AhmadMahi/nexus-face/(commit log)

2026-09-24 NEXUS Face: ESP32-C3 companion with knock navigation and OTA
    Knock driven: one for next, two for the next screen, three to act, four
    for home. Eight screens covering clock, weather, messages, the animated
    face, sensors, settings and system.
    The ADXL only reports single taps, so taps are collected into a burst
    and classified afterwards, which is the only way to tell three from two.
    Weather from Open-Meteo, located by IP. The clock uses NTP, and falls
    back to the time your browser hands over when there is no route out.
    Settings are a real list you can drive by knocking: brightness, sleep
    timeout, eye style, check for update, reboot.
    Credentials are copied into flash on first boot and read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
2026-09-24 v1.2.0: work sessions, and fix the story never arriving
    The story always failed with 'bad reply'. ArduinoJson was being handed
    h.getStream() directly, which is the raw socket including the chunked
    transfer markers OpenAI replies with, so the parse could never succeed.
    It reads through getString() now, which unpicks the chunking first. The
    screen also reports the real reason instead of always blaming a missing
    key, and the key has its own endpoint so saving it no longer needs a
    reboot and takes effect immediately.
    New FOCUS screen and a plan you build on the page. Each stretch has a
    name and a length, runs in order with a countdown filling the screen
    and the name scrolling underneath, and fl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
2026-09-24 v1.4.1: say why an update will not fit
    "no room" was the whole message, which told you nothing and sent you
    looking in the wrong place. The slot an update lands in is fixed by the
    partition table, that table is written over USB, and nothing done over the
    air can change it. So the device now names the numbers: "will not fit",
    then "1352k into 1280k slot". A board with no second OTA slot at all says
    so separately.
    The page carries the same figure under System as "ota room", so the
    ceiling is visible before you walk into it.
2026-09-24 v1.4.2: eyes with pupils, and cards that wait for you
    The eyes were filled shapes, which read as blocks rather than eyes. Each
    one now carries a pupil and a glint, on every frame the face appears in:
    boot, waking, dozing off and falling.
    The card at the end of boot ran out a fixed delay, so knocking during it
    did nothing and the knock then arrived late, after the card had gone. A
    knock now ends the card within a single poll, and the rest of that burst
    is muted so it does not also step the carousel. The same applies to the
    name card and both offline cards.
    That card is also rebuilt. "READY" was in the corner of a title bar and
    the four knocks were two ragged centred lines. It now reads HOW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
2026-09-24 v1.5.0: the call to prayer, a calmer face, and a name
    Named RAFIQ, which is Arabic for companion, and what the thing actually
    is. The repo, the sketch and the release asset keep their old names so
    updates already out in the field still find them.
    The face was twitching. The library clears the panel and pushes it itself,
    so a caption added afterwards needed a second push and the panel showed
    both frames. Boot now draws its own eyes and pushes once, so it sits
    perfectly still, and the blink went from every three seconds to every
    seven or so. Each boot stage also looks like what it is doing: a sweep
    that lights each sense as it passes, waves going out for the network, and
    a face with a hand go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
2026-09-24 v1.6.0: two games, played by tilting
    GAMES sits between SHORT READS and SETTINGS. Two knocks opens it, one
    knock moves between the two icons, two knocks plays.
    Snake steers by tilt, four ways, and works up from 220ms a step to 120ms.
    That floor is deliberately slower than a keyboard snake would want, since
    tilt carries more lag than a button does.
    Brick slides its paddle by tilt, proportionally, and the paddle edges send
    the ball off at an angle so it steers as well as blocks.
    Tilt is meaningless without knowing how the thing is sitting, and this one
    could be upright or flat. Rather than guess, it asks once: hold still,
    tilt right, tilt away. That mapping is kept in flash and never asked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
2026-09-24 Add an input test build, and draw the car as a car
    The test build is a detour, not the firmware. It carries WiFi, the
    clock, the page and OTA, and nothing else, so three ways of driving the
    device can be judged against each other without anything else in the
    way: tilt, squeeze and taps.
    It always installs whatever release is current, even one numbered below
    itself. A version check would otherwise strand the device on it, and
    this is meant to be left.
    Worth saying plainly about squeeze: this board cannot feel one. There is
    no force sensor, and unlike the older ESP32 the C3 has no touch
    peripheral at all. What the detector watches for is the patch of low
    frequency wobble a hand leaves when i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
    [rafiq_test.ino]
2026-09-24 v2.0.0: lean to drive it, and an About page
    Squeeze is gone. The board cannot feel one, the detector was guessing,
    and a control you cannot rely on is worse than no control at all.
    Tilt earns its place instead, as a second way in rather than a
    replacement. Knocking keeps working exactly as it did, always, so a lean
    that is misread or a calibration that has drifted can never strand you
    on a screen with no way back.
    Lean down for the next thing, up for the one before, left to go in,
    right to come out, and hold it up for three seconds for home. Up does
    double duty, so it only counts as "the one before" once you let go:
    holding past three seconds means you wanted home, and it does not fire
    bot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
2026-09-24 v2.0.1: choose what to install, rather than just taking the newest
    Check update used to be a single button that fetched the newest release
    and wrote it, with nothing in between. It now opens two choices.
    Newest release names what it found and asks before writing anything. One
    knock moves between Yes and No, two knocks answers.
    Earlier releases lists the last eight with the running one marked, and
    asks the same question about whichever is picked. Going back to an older
    build is deliberately allowed: there should always be a way off a release
    that turned out badly, and the confirmation step is what makes that safe
    rather than reckless.
    The install path no longer compares versions at all. Th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
2026-09-24 v2.0.2: stop the fall animation firing when you lean it
    It was never going to sleep. The eyes were closing because the fall
    animation was running: it ends by flattening them to six pixels for
    forty frames, which looks exactly like eyes shut, and input() has
    already returned by then so nothing responds for about a second. Shaking
    it appeared to wake it because the animation had simply finished.
    It only showed up with leaning because leaning is the only reason to
    pick the thing up. On a desk it never unloads.
    The free fall detector was set to 438mg for 100ms, the sensitive end of
    the datasheet range and a window far shorter than any real fall: a drop
    from desk height is 250ms or more. A hand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
2026-09-24 v2.0.3: the sleep loop, which was a stuck lean all along
    The pattern of sleeping, waking on a shake and sleeping again was the
    real fault, and it was not the fall detector.
    Rest is measured while you hold the device, because the calibration asks
    you to hold it. Put it down on a desk afterwards and the resting pose no
    longer matches: every lean reads as already held over. The gesture latch
    only clears when the lean returns near zero, which now never happens, so
    no gesture fires again. Nothing then refreshes the idle timer, so it
    sleeps, wakes on a shake, and sleeps again. Exactly as described.
    Once it has sat still for five seconds, rest now settles to wherever it
    is actually sitting. Recov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
2026-09-25 v2.0.4: leaning it can finally wake it
    The sleeping was never the fall detector, and it was not the stale
    resting pose either. Both of those were real, and fixing them changed
    nothing you could see, because neither was the cause.
    Every check that woke the device or kept it awake tested the MAGNITUDE
    of the acceleration. Gravity has the same magnitude whichever way the
    thing is turned: leaning it changes the direction, not the size. A forty
    five degree lean moves the magnitude by about one hundredth, well under
    the twelve hundredths those tests wanted, so a lean was invisible to all
    of them. The gyro term was the only one that could have caught it, and
    it reads zero unless you are mid rotati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
2026-09-25 v2.0.5: a way to stop it, and something to look at
    Four goes at this and it still sleeps, so this release stops guessing.
    SETTINGS, Sleep after, now has "never" on the end of the list. That ends
    the dozing immediately whatever is causing it, and it costs nothing on a
    device that sits on a desk. Existing settings keep their meaning because
    never was appended rather than put at the front.
    The page has a "Why it sleeps" card, live: awake or asleep, how long it
    has been idle and against what limit, what woke it last, how many times
    it has slept, whether each sensor is answering, the raw gravity vector,
    and how far the lean reading has moved against the threshold it has to
    cross. Enough to see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
2026-09-25 v2.1.0: watch faces, and prayer times that stay put
    Ten faces for the clock screen, chosen in SETTINGS. Six laid out by
    hand, two that lean the way you do and right themselves a couple of
    seconds after the thing is set down, and two with something that pours.
    Whatever the water or sand covers is inverted rather than swallowed by
    it, so it stays readable as the level moves. The faces read the sensor
    themselves, so they work whether or not leaning drives the device.
    Prayer times are no longer refetched daily. They are kept in flash and
    refreshed only when asked, from SETTINGS, or once every fiftieth boot.
    They barely move week to week, and refetching meant losing them whenever
    the network hap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
2026-09-25 v2.2.0: a Mac in the loop, and a door that closes
    Rafiq on the Mac drives the robot over the same API the page uses, so
    there is one command set rather than two. Nothing here becomes a
    dependency: close the laptop and the clock, the prayer times, the reads
    and every knock carry on exactly as before.
    pairing six digits on the panel, and after that every call has to
    carry the token. This closes a door that was standing open
    since the beginning: anyone on the same network could post
    to this device. The page pairs the same way and stays the
    way back in, so a failing app can never lock you out.
    focus start it from the Mac. Th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
2026-09-25 v2.3.0 and Rafiq 1.2: reminders, breaks, and a calmer focus screen
    The focus screen was three hard edges stacked on a 128x64 panel: an
    inverted title bar, a boxed progress rail and a scrolling task name.
    What is left is a word, the time, and a thin line showing how far in you
    are, with room around all three. Hours only appear once there are hours.
    on a break the Mac locks itself and the robot holds the sign, with a
    countdown, so anyone at the desk can see without asking.
    camera, mic one flag per device, read from the system by the Mac and
    forwarded. Nothing is heard, seen or recorded: the only
    thing known is whether a device is switched on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
2026-09-25 Rafiq for Windows
    The same companion as the Mac one, written in C# against .NET 8 WinForms.
    I have no Windows machine here, so it is built and exercised on a real
    Windows runner instead of cross built blind: the workflow compiles it,
    runs a suite against a stand-in robot on localhost, launches the tray app
    and checks it is still up eight seconds later.
    Twelve tiles in four rows, the compose field below them, pairing, quick
    phrases, reminders, on a break, camera and mic, light and dark, the
    rafiq command, and updating itself from this repo under win-v tags.
    Three things Windows does differently, and the Mac notes say so too:
    locking LockWorkStation, a plain documented call, where ma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
2026-09-25 Windows: one binary for the tray and the command
    Shipping a rafiq.exe beside Rafiq.exe cannot work: Windows file names
    ignore case, so the command quietly replaced the app's own launcher and
    what shipped was a framework dependent console exe in a self contained
    folder, which refused to start at all. The build machine caught it.
    Given arguments the same binary is the command and borrows the console
    it was typed into; a rafiq.cmd shim beside it keeps the name.
2026-09-25 Both apps: stop the tiles fighting each other, and fix two real faults
    The pointer was the worse of the two, and the cause was not obvious.
    Timer.scheduledTimer only puts a timer in the default run loop mode, and
    a menu bar window switches the run loop to event tracking for as long as
    it is open. Every timer in the Mac app was therefore dead precisely while
    you were looking at the panel: no pointer packets went out, the robot's
    tracking lapsed after a couple of seconds, and the eyes went back to
    normal on their own. Proven with a run loop test before touching it, and
    all eight timers now run in .common. Windows uses message timers and
    never had this.
    The reminder clock could be seen but not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
2026-09-25 v2.4.0: leaning it about is gone
    It was offered as a second way to drive this from v2.0.0 and never
    worked properly. The cause was real and was found: a lean does not
    change how hard gravity pulls, so every check that kept the device awake
    was blind to one, and it dozed off mid gesture. Four attempts at it were
    each a genuine fix for a genuine bug and none of them cured the symptom.
    Switched on by accident it made the thing unusable, which is a poor
    trade for a feature nobody was relying on.
    So the Control setting goes, and with it the lean navigation, the
    calibration it forced at boot, the lean half of the boot card, the web
    page buttons, the /api/control endpoint and the counters behind i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
2026-09-25 v2.4.1: finish the job on the page
    v2.4.0 took leaning out of the device but left its traces on the web
    page: a Control card with nothing left in it, two System rows reading
    fields the device no longer sends, and the sleep diagnostics still
    talking about leans. Loading the page against a stub is what found it.
    The diagnostics rows are renamed to what they actually measure. What
    wakes the device is movement in any direction, not a lean, and calling
    it a lean on a device that does not navigate by them was only ever going
    to mislead.
    knockPrev goes too. Going backwards round the carousel was something
    leaning gave for nothing and knocking never had, so with leaning gone
    nothing could reach it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
2026-09-25 v2.4.2: the update check was about to stop finding updates
    GitHub's "latest release" means the most recently published one, and
    this repository carries the Mac and Windows apps as well as the
    firmware. Asking for the latest worked only while a firmware release
    happened to be the newest thing in it. The next Rafiq release would have
    handed the robot a zip full of Windows, no firmware image in it, and the
    device would have reported that there was no release to be found, with
    no way to tell from the screen that the fault was mine.
    So it walks the release list and takes the newest one that actually
    carries a firmware image. The earlier releases list already did this
    correctly; it just asked for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
2026-09-25 v2.5.0: the screen stops going deaf while it fetches
    You said it freezes when you come back to the clock and that knocking
    does nothing for a while. It was not the menus. Fetching ran on the very
    loop that reads knocks and draws the screen, and it was deliberately
    held back until you had been still for two and a half seconds, so the
    reliable way to meet it was to finish navigating, settle on the clock,
    and stop touching the thing.
    Every timeout is set twice over, once to connect and once to read, so
    the worst case was far past annoying:
    the clock up to 3s
    where am I up to 12s
    weather up to 16s
    prayer times up to 18s
    all of them in a row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
2026-09-26 v2.7.0: trying a tap out properly, and sleeping properly
    the try screen was wrong and you were right about it. A single knock
    inside it is the thing being tested, so it must do
    nothing else, and it was walking the menu at the same
    time. It is a list now: knock through the strengths,
    two knocks to go in and hit it, two knocks to come
    back. Inside, single knocks only count, and there is a
    rolling trace of how hard the last two dozen shoves
    were beside the number. Every jolt goes in it whether
    the chip counted it or not, because the short bars are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
2026-09-26 v2.8.0: more than one network
    Home, a phone hotspot, wherever else. Up to five. It works down the list
    until one answers and stays there, and starts down it again if that one
    goes away, so carrying it out of the house and tethering it is nothing
    you have to set up twice.
    There was no reconnect logic at all before this, only whatever the radio
    did by itself. The walk lives on the network task, so waiting seven
    seconds on a network that is not there costs the screen nothing.
    Slot zero keeps the old ssid and pass keys, so a device that has been
    running for months comes up on the network it already knows and only
    then notices it can hold four more.
    Names rather than Strings for the list, beca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
2026-09-26 v2.9.0: the settings the app was asking for, and a word that stays put
    Most of the robot's settings did nothing from Rafiq, and that was my
    fault twice over. The endpoint they call, /api/cfgv, was written and
    then never released: I added it while building the app and tagged the
    firmware before it. So brightness, watch face, sleep after, popup time
    and eye style were being sent to a robot that had never heard of them,
    while tap strength, networks and reboot worked because those endpoints
    had actually shipped. Page turn was worse: the device did change, but
    the tile read the new value back from a state field that had not
    shipped either, so it looked like nothing happened.
    Both go out now, and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
2026-09-26 v2.14.0: ten more faces, with hands on some of them
    Twenty faces now. Three with hands, one that is half hands and half
    rings, five made of what the robot knows about itself, and one for
    showing off.
    dial a whole watch: ticks, hour, minute and a ticking second
    bauhaus no case, four marks, two hands
    regulator hours and minutes on the left, seconds on their own dial
    to the right, date under it
    rings hour, minute and second closing as arcs, time in the middle
    infograph small time, one fact in each corner: signal, temperature,
    date, next prayer
    status the time large, then signal and dBm, uptime and boot count
    vitals boots, uptime,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
2026-10-01 v2.15.0: a touch pad on GPIO5 turns the screen inside out
    Hold the pad and the whole panel goes inverse. Let go and it comes
    back. That is the entire feature: nothing to find in a menu, nothing to
    remember, and it answers the only question being asked, which is
    whether the thing is wired up right.
    GPIO5 was free. 8 and 9 are the I2C lines, 4 is the accelerometer
    interrupt, and 2, 8 and 9 are the strapping pins.
    Read with digitalRead and not touchRead, because the C3 has no
    capacitive touch peripheral at all, unlike the original ESP32 and the
    S2 and S3. A pad on this chip is a little board doing its own sensing
    and handing over a level.
    Which level means touched is up to that board. Most p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
2026-10-01 v2.16.0: the touch pad, told what it is actually plugged into
    It is a TTP223, and knowing that turns up a bug in v2.15.0.
    A TTP223 has two solder pads on the back. They choose whether the
    output goes high or low on a touch, and whether it is momentary or
    latching. Four combinations, and the board does not say which one it
    is in.
    v2.15.0 took a reading at boot to decide which way round the pin was
    driven, and flipped that decision if a touch ever lasted thirty
    seconds, on the grounds that nobody holds a pad that long. Nobody does,
    but a TTP223 jumpered to latch holds the pin itself, quite properly,
    until the next touch. Against that board the flip would have fought
    the sensor and kept flipp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
2026-10-01 v3.0.0: the pad drives it, and knocking is something you switch on
    Three, because the way you work it has changed.
    one press next. The next screen, the next thing in a list
    two open, choose, confirm
    three straight home from wherever you are
    long press back, out one level
    A single cannot be acted on the moment you lift, because a second might
    be coming: it waits 300ms. A double waits the same again in case a
    third follows. A triple does not wait at all, since nothing longer can
    come after it, and a long press fires at 700ms with your finger still
    down, which is why it is the most immediate of the four.
    A long press on the clock has nowhere back to go, so it ope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
2026-10-01 v3.1.0: press and hold to go in, and a press that looks like one
    one next
    long in, with the screen pulling in and springing back
    two back, out one level
    three home
    Holding to go in is how holding works nearly everywhere else, and it
    leaves a double free to mean back, which is what it means now.
    Where there is nothing left to open that rule has nothing to say, so a
    leaf reads differently: in a reader, in zikr and while walking the
    faces, one is the next, two is the one before and a long press is the
    way out. Turning back a page without leaving the page is worth the
    second rule.
    The inverse blink is gone. It said "something happened" without saying
    it felt like a press. Goi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
2026-10-01 v3.2.0: what is left in the pack, and a press that does not hang about
    The battery, on GPIO1 through the two 200K resistors. Settings, System,
    fifth row: what is left and the volts it worked that out from, because
    a percentage with nothing behind it is hard to argue with when it looks
    wrong. Nothing plugged in reads as "none" rather than as a flat cell.
    Read with analogReadMilliVolts rather than analogRead, so it uses the
    calibration burned into the chip rather than assuming a perfect
    reference, and at the widest attenuation, because half of a full cell
    is about 2.1V and the default range would call that maximum for the
    whole top half of the pack.
    The percentage follows the shape a lithium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
2026-10-01 v4.0.0: it keeps its own reminders, and switches itself off
    Four, because it now sleeps properly and wakes itself up, which is a
    different machine from the one that stayed on all day.
    HOLDING, IN THREE PARTS
    0.7s in
    5s back to the clock
    10s switch off
    Nothing is shown for the first five seconds, so ordinary use is as
    quiet as you asked for it to be. Past five it says what letting go
    will do, because nobody holds a pad for five seconds by accident and
    by then you want telling. Both of the long ones act on release, so
    holding on through one and into the next changes your mind for you.
    Switching off says goodnight rather than going dark mid sentence: the
    eyes close, and it sa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
2026-10-02 v4.2.0: the other calendar, and Arabic numerals to read it in
    Three faces:
    arabic the time in ٠١٢٣٤٥٦٧٨٩, and the Hijri month in Arabic
    hijri an English clock whose date line keeps changing its mind
    crescent a moon, the time, and the Hijri date under it
    THE ARABIC
    The panel font is 5x7 and ASCII, so Arabic cannot be printed, only
    drawn. Ten digits in two sizes and the twelve month names are shaped on
    a machine that has a shaper and a font, and arrive here as bitmaps.
    Three kilobytes for the lot.
    Worth writing down, because it cost an hour: the usual recipe is to
    reshape the string and run it through the bidi algorithm before
    handing it to the renderer. On this mac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
2026-10-02 v4.3.0: a reminder you can set from the address bar, and one that lets go
    THE LINK
    /api/remind takes "in" now as well as "at", and answers to GET with the
    token as a parameter, so the whole thing fits in an address bar:
    http://robot/api/remind?t=TOKEN&text=Call+mum&in=45
    http://robot/api/remind?t=TOKEN&text=Call+mum&at=18:30
    Somebody who wants reminding in forty minutes should be able to type
    it, or hand it to a Shortcut, rather than compose a request. The app
    has both, made up with your own address and token, with a copy button.
    THE LADDER
    Ignoring one used to buy half an hour, for ever. Now the gaps grow and
    then it stops:
    5, 5, 5, 30, 30, 60, 60 minutes, and then it lets go
    T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
2026-10-02 v5.0.0: offline is a mode, not a fault, and the bike is on the shelf
    Five, because the robot now has two ways of being.
    OFFLINE
    Two different things, kept apart. Asked for in settings, the radio goes
    off and stays off. Tried and found nothing, the radio goes off too,
    because a chip scanning for a network that is not coming back is a way
    of spending the battery, but it looks again on the next wake.
    Either way the home screen stops being a clock and says hello: a
    greeting that changes, your name, and touch to begin. The time and the
    charge sit small in the corners, because a robot that knows what time
    it is and will not say is an irritating robot.
    The weather leaves the carousel, since it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
2026-10-02 v5.1.0: the reminders screen, and the shake that was closing it
    THE BUG
    Holding on the reminders screen looked like nothing happening. It was
    not nothing: it went in, and then came straight back out.
    Shake to go back was reading your finger. The pad is glued to a small
    light robot, and pressing a pad glued to a small light robot shakes the
    small light robot. Six tenths of a g is a firm press. So the hold
    opened the list, the press registered as a shake, the shake stepped
    back, and you were looking at the summary again a frame later.
    A shake now only counts when nothing is touching the pad and nothing
    has been for eight hundred milliseconds. A real shake, a moment after
    you let go, still w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
2026-10-02 v5.2.0: a vehicle you choose, a radio that stays off, a reminder you can read
    Vehicle
    Six layouts instead of four, and picking one works the way setting
    the clock works: hold to open the chooser, press to walk them, hold
    again to keep the one in front of you. It used to change on a long
    press with nothing asked and nothing confirmed. Make and model are
    two fields now, because "Royal Enfield Meteor 350" is twenty four
    characters and the screen is twenty one wide.
    Off means off
    Told to stay offline, boot no longer sets the radio mode, scans,
    joins, or starts the web server. The setting was read before all of
    that and then ignored by it, so a board told to stay off still woke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
2026-10-02 v5.3.0: touch wakes it again, and the stopwatch is a stopwatch
    Touch not waking it
    The pad's resting level is measured at boot, and waking from deep
    sleep IS a boot: the probe runs thirty milliseconds in, with the
    finger that woke it still on the pad. So it learned the touched
    level as the resting one and everything inverted from there. The pad
    read as pressed whenever nobody was near it, and the next sleep
    armed its wake on the resting level, so touching it did nothing.
    It only started biting now because deep sleep only started happening
    often: offline, the robot switches off the moment the screen
    darkens, so this ran on nearly every wake and each wake made it
    worse. Th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
2026-10-02 v5.4.0: the reminders open, and the menus speak touch
    The reminders
    loop() clears depth on every pass for any screen that does not have
    an inside, and the list of screens that do was written out by hand
    in the middle of it. S_REMIND was never added to it. So holding set
    depth, the zoom played, and two milliseconds later the next pass
    through the loop put depth back to zero: opened and closed faster
    than the screen could draw. All you ever saw was the animation and
    the summary again, and the next press walked the carousel because by
    then you were back at depth zero.
    That is the whole of it, and it had nothing to do with either of the
    two things fixed before it. The rule n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
2026-10-02 v5.5.0: the update screen had no way out, and the reminder card is a card
    Check update could not be left
    It takes the panel and returns from loop() before anything else
    draws, and it was driven only by knocks. Knocks are off unless you
    ask for them. So opening it put a screen in front of you that the
    pad could not touch: presses fell through to the carousel
    underneath, invisibly, and nothing came back. Not a crash, but
    nothing short of the battery got you out of it.
    The pad drives it now: one walks the two choices, holding picks one,
    two goes back, three leaves. A shake leaves it and so does the five
    second hold home, which used to set the screen behind it and change
    not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
2026-10-02 v5.6.0: hold to wake it, and a long press that stops blinking
    Wake on hold: off / 1s / 3s, three by default
    The wake cannot be made to wait. The chip is off, the wake is a
    level on a pin, and there is no duration anywhere in it. So it
    wakes, looks, and lies back down.
    The looking happens before everything: before the serial port
    settles, before the settings are read, before the sensors, the
    display or the radio, and before the boot counter is written. A
    sleeve brushing the pad used to cost a full wake with the screen on
    and the radio up for the whole of a screen timeout. It now costs a
    couple of hundred milliseconds of a processor that had to start
    anyway.
    Three secon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
2026-10-02 v5.7.0: the countdown stops watching the pad, and the pad gets measured
    Holding
    Five seconds says what holding on does. Eight seconds decides it:
    the robot goes home right then, and the countdown to switching off
    starts. Ten was too far, and letting go between five and eight is
    still just going home.
    From eight seconds the pad is out of it. The countdown reads off its
    own clock, letting go does not stop it and does not hurry it along,
    and a fresh touch is what cancels. That is the point of the change.
    A TTP223 releases on its own if a pad stays covered, so anything
    that waited on a finger still being reported after that moment was a
    decision the hardware could take away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
2026-10-02 v5.8.0: one hold, one meaning
    Five seconds goes home. That is all it takes and nothing is shown
    before it. The moment it gets there the robot is at home and the
    countdown to switching off is on screen: three, two, one. Let go
    during it and it stays, at home, which is where you were going. Hold
    through it and it switches off.
    There were two tiers before, five seconds and then eight, with a
    screen in between explaining the difference between them. Two things
    to hold through, two overlays to tell apart, and a rule about which
    one the pad was allowed to end. One move that does one thing, with
    three seconds to change your mind, is better than that.
    The house overlay and the second tier are gone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
2026-10-02 v5.9.0: four seconds, and a dial instead of a notice
    Four seconds goes home and starts the count. Three to change your
    mind. Seven in all, down from eight, and nothing on screen before the
    four.
    The overlay is a dial now. Two solid white bands, one top and one
    bottom, is most of a panel this small; they are gone, and the words
    sit plainly above and below. The track is dotted all the way round so
    there is something for the lit arc to be a fraction of, three notches
    outside it mark the seconds so it reads as a count rather than as
    something draining, and the number sits in the middle of it.
    The geometry is measured from the source rather than written down
    twice. It caught the first attempt,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
2026-10-03 v5.10.0: four seconds decides it, and the clock is asked again on waking
    Holding on could never switch it off
    Your report says the pad lets go on its own at about five seconds,
    and that is exactly what the symptom was. The count began at four,
    the TTP223 released itself a second later with two still showing,
    the firmware read that as you letting go, and it announced it was
    staying up. There was no length of hold that could have worked:
    the chip let go before you would have.
    Four seconds is the whole of the decision now. The three that
    follow are an announcement, not a question, and nothing after the
    four can take it back. That is the only arrangement the pad cannot
    beat.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
2026-10-03 v5.11.0: gesture mode
    The pad, pointed at your Mac. One press and two go across and Rafiq
    decides what they mean, which can be different in every application
    you have in front of you.
    Nothing here is remembered. The robot comes up as a robot, the app
    switches the mode on when it finds it, and the robot drops it the
    moment the app stops answering. So quitting Rafiq gives you your
    robot back, and so does holding the pad for four seconds, which in
    this mode leaves the mode rather than switching the robot off.
    Presses are pushed, not waited for. The Mac asks the robot how it is
    every ten seconds, which is fine for "are you there" and useless for
    a press. A UDP packet carries it across the room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
2026-10-03 v5.12.0: gesture mode is knocking, and it rests dark
    Knock the desk, not the pad
    Knocking is the gesture now. One knock and two go to the Mac, and
    in this one mode they work whether or not knocking is switched on,
    because here knocking is the mode.
    The pad does nothing at all in gesture mode beyond the four second
    hold that ends it. It used to send as well, which is a double send
    waiting to happen: pressing a pad glued to a small light robot
    knocks the small light robot. The same jolt the shake handler had
    to be taught to ignore would have reached the Mac as a second tap.
    It rests dark and cannot switch off
    Ten seconds and the panel goes out, whatever the sleep setting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
2026-10-03 v5.13.0: knock, touch, or either
    Gesture mode can listen for a knock on the desk, a press on the pad,
    or both, chosen in the app.
    Both is the one that needed care. Pressing a pad glued to a small
    light robot knocks the small light robot, and the knock lands first,
    on the press, while the press itself is not resolved until you lift.
    Left alone, one press would reach the Mac twice. A knock that arrives
    with a finger on the pad, or shortly after one left it, is that
    finger, and is thrown away.
    The screen says which it is listening for, so there is no guessing.
2026-10-04 v5.14.0: the settings in four groups
    Twenty four rows in one list is a list you scroll through hunting for
    the thing you came for, and the thing you came for is usually the
    network or the brightness, which were eight apart.
    Display, Wireless, Controls, System. All four on one screen, then a
    short list. Worst case goes from twenty three presses to seven and
    the average from eleven and a half to four.
    Display is first, and in the order the flat list had, because that is
    what makes this strictly better rather than a trade. Grouping costs a
    press to reach the group, so anything near the top of the old list
    would have ended up further away. Five of them did, and sim_groups.py
    said so: Brightnes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
    [partitions.csv]
2026-10-04 v5.15.0: Bluetooth mode and pairing
    Settings, Wireless, Network now walks three ways: wifi, bluetooth,
    off. In Bluetooth the WiFi radio never starts at all, the robot
    advertises as "Rafiq <your name>", and you pair it once from Settings
    on the iPhone. iOS reconnects on its own after that.
    The two radios are never both up. One aerial; two radios on it is one
    radio's worth of each. Every path that changes the mode takes the
    other one down first, including asking for the rescue hotspot, which
    used to leave Bluetooth running.
    cfgOffline is now one line rather than a variable: there is no WiFi
    to be had in Bluetooth mode any more than in Off, and every piece of
    logic that asks wants the same an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
2026-10-04 v5.16.0: speak HID, or an iPhone will never list it
    v5.15.0 advertised correctly and was never going to be found. iOS
    Settings does not enumerate plain BLE peripherals at all. That page is
    for classic radios and for the handful of standard profiles the system
    consumes itself, HID chief among them; everything else is reachable
    only from an app holding CoreBluetooth. So the robot sat there saying
    "pair me" to a phone that was not listening for it.
    It now advertises HID over GATT as a mouse, which puts it on that page.
    A keyboard would work too and is the wrong choice: iOS hides the on
    screen keyboard whenever a hardware one is attached, so a paired Rafiq
    would have taken the keyboard off the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
    [render_bt.py, sim_bt.py]
2026-10-04 v5.17.0: fix the boot loop 5.16.0 caused
    5.16.0 bricked the robot the first time anyone chose Bluetooth. One
    line did it:
    btHid->manufacturer("Rafiq");
    That overload writes through m_manufacturerCharacteristic and nothing
    else. The thing that CREATES that characteristic is the no-argument
    manufacturer(), and the constructor never assigns the pointer at all,
    nor does the header give it an initialiser. So it stored through
    whatever happened to be on the heap and panicked. The core's own
    example calls manufacturer()->setValue(...), which is the pair of them
    in the right order. Fixed that way.
    The panic was recoverable. The boot loop was not, and that is the
    worse bug: C_MODE writes the m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
    [sim_hid.py]
2026-10-04 v5.18.0: the clock comes from the phone
    Stage 3, now that the pairing is real. iOS serves the Current Time
    Service to anything it has bonded with, so in Bluetooth mode the robot
    asks the phone what time it is and stops minding that there is no
    WiFi. clockSrc reads "your phone".
    It could not go through BLEClient, which only dials out and has
    nothing to attach to on a connection the phone made. It is NimBLE's
    own ble_gattc_* over the connection handle the server callback already
    had: discover 0x1805, find 0x2A2B in it, read it. The three callbacks
    run on the host task, so they do nothing but write down what they
    found; the clock is set in ctsTick on the main task, next to
    everything else that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
2026-10-04 v5.19.0: safe mode, because the case is sealed now
    The Bluetooth count added in 5.18.0 only knows about Bluetooth.
    Anything else that panics on the way up would loop exactly the same
    way, and the robot is a closed box now: no cable, so if it cannot
    reach a network it cannot be fixed at all.
    A panic reboots the chip and sets the reset reason, so consecutive
    panics can be counted without writing to NVS on every ordinary boot.
    A clean start clears the count; three panics running and it comes up
    on WiFi, says SAFE MODE / ON WIFI, UPDATE ME, and waits to be fixed
    over the air. Gesture mode needs no handling because it is off at
    boot and only the Mac ever turns it on.
    ESP_RST_DEEPSLEEP and ESP_R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
    [sim_hid.py]
2026-10-07 v5.21.0: the pad could put the robot to sleep for ever
    If the resting level is ever learned the wrong way round, the pad
    reads as permanently pressed. A long press fires at 0.7s, the switch
    off arms at four seconds, and the robot is in deep sleep at seven. A
    deep wake reloads the same remembered wrong level and does it again.
    The correction for a wrong resting level existed, but it needed sixty
    seconds at one level and the robot never stayed awake past seven, so
    it could never be reached. Sleeping by itself at odd intervals and
    unusable in between is exactly what that looks like.
    sim_pad models it at the real poll rate and reproduces it: asleep at
    7110ms, eighteen times a minute, the correc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
    [sim_batt.py, sim_gesture.py, sim_settings.py]
2026-10-07 v5.22.0: a .bin from the page
    The release path needs the internet. This one needs nothing but the
    robot's own page, which is the point of it: on the hotspot, with no
    network and no cable, a file from your phone is the only way in.
    Firmware from a file, under Update. Pick a .bin, confirm, and it
    streams straight into the spare OTA slot with a percentage on the page
    and on the robot's panel, then restarts into it.
    The ordering is the part worth stating. WebServer takes two callbacks
    for an upload: one that runs while the bytes arrive, and one that runs
    once they all have. The authorisation is checked in the FIRST, because
    by the time the second runs the whole image is already written to the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
2026-10-09 7.10.0: the five open items, and a way to see the faces
    After a drop, the robot went through its animation and then stayed
    awake for the next several minutes over something nobody watched. It
    now goes straight back to sleep if it was asleep when it fell.
    The four hub items that are a list open the list. Choosing
    Notifications and then having to open Notifications is a step that
    buys nothing, and the same for Reminders, Short reads and Games.
    Weather, Vehicle, Prayer times and Mac are a screen rather than a
    list, so they stay where they were. An empty list still opens at its
    summary, because "nothing yet" is better read on the screen that says
    it.
    Waking it yourself with something waiting t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
    [partitions.csv]
2026-10-09 7.10.1: why sending firmware over Bluetooth took so long
    It asked for a connection interval of 7.5 to 15 ms. Apple requires the
    minimum to be at least 15 ms, to be a multiple of 15 ms, and the
    maximum to be at least 15 ms above it. That request breaks all three,
    and a central that does not like a request simply refuses it. The
    refusal is silent: no error, no log, nothing to see. The link stayed
    at the ordinary 90 to 120 ms with a latency of 4 and sent 1.5 MB at
    that rhythm, which is why the hotspot finished in moments and this did
    not.
    It now asks for 15 to 30 ms with no latency, which is inside the rules
    and should actually be granted.
    Two more things were undoing it. idleRhythm watches f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
    [conn_check.py]
2026-10-10 7.11.0: Sync asks the Mac instead of raising WiFi
    The robot's Sync brought its own WiFi radio up to fetch the weather,
    the prayer times and a story. The Mac already does all three and sends
    them over Bluetooth, so WiFi was being raised to do work that was
    already being done without it, which is the opposite of the point.
    With a Mac on Bluetooth, Sync now sends "want sky" and "want read" and
    the Mac fetches and sends. WiFi is still the fallback when there is no
    Mac to ask.
    macOnBle is new because macLinked is the old WiFi answer and says
    nothing about Bluetooth, which is where a Mac actually lives now.
    0 warnings. 125 tests. 22 screens, 0 problems. 7 connection requests,
    all legal. 1,840,9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
    [sim_reads.py]
2026-10-10 7.11.1: built on the patched core, so it stops switching itself off
    The robot was going into deep sleep with the phone and the Mac both
    connected. The cause is not in this file: 7.10.0, 7.10.1 and 7.11.0
    were all built against a stock core.
    Without the light-sleep patch esp_pm_configure fails, so pmAvail is
    false. phoneHeld() is
    pmAvail && cfgNet == NET_BT && btUp && btConn != 0xFFFF
    so with pmAvail false it reports no phone however many devices are
    linked, and backToSleep reads that as being alone and asks for deep
    sleep. The robot also never light-slept, which is most of the battery.
    None of it is an error. It compiles, it runs, and it says so in one
    line of the serial log: "power: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
    [pm_check.py]
2026-11-13 7.13.0: a radio that sleeps, a processor you choose, and a keyring
    Four settings and a mode.
    BLUETOOTH, always on or smart. Always on is what it has always done:
    the link stays up, notifications arrive the moment they are sent, and
    that is where the battery goes. Smart brings the radio up, takes the
    time, and puts it away again; a day later it comes back for a few
    seconds and takes it again, because a C3 has no crystal and the clock
    drifts. Nobody answering is not worth hammering: it waits an hour.
    Switching notifications off from a Shortcut now moves it to smart, and
    switching them on moves it back. A robot told not to show
    notifications has no other reason to hold a link open, and one to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
2026-11-13 CI must not overwrite a release binary that is already there
    The 7.13.0 asset was uploaded and checksum verified at 15:18. This
    workflow finished at 15:21 and replaced it with its own build, so the
    release served 1,850,096 bytes nobody had looked at instead of the
    1,861,392 that was tested. Nothing failed and nothing said anything.
    The only trace was the size.
    The publish step now reads the release first and leaves nexus_face.bin
    alone if it is already up, so a hand built asset wins and a tag pushed
    on its own still gets a binary.
    Two reasons the two builds differed at all, both fixed here:
    - the FQBN left out CDCOnBoot=cdc, so CI was building a different
    board configuration from th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
2026-11-13 A wiring diagram, and the keystore password out of DECISIONS.md
    WIRING.md draws what goes where and says why each pin is the one it is:
    the C3 can only wake on GPIO 0 to 5, and 2, 8 and 9 are strapping pins,
    which is most of the reason there was never a choice.
    It also writes down the two things that catch people out and are not
    visible in a photograph of the wiring: 200K over 200K puts 100K in front
    of an ADC that wants under 10K, so the first read after a gap comes back
    low, and a TTP223 has four jumper combinations that the board does not
    label, which is why nothing about its output is assumed.
    docs/wiring.svg is the diagram. docs/rafiq.png is the first photograph of
    a built one, cut ou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
2026-11-13 7.14.0: a keyring that stays one, and notifications that own the radio
    Keyring mode did not work, and the reason was two words long. keyShut
    and keyBootAt were plain globals. A wake from deep sleep runs setup()
    again with RAM back at its initialisers, so every single time the thing
    was picked up it came back with keyShut false and handed out another
    thirty seconds of the ordinary robot, radios and all. It was never a
    dumb device. It was the normal robot going quiet, over and over.
    The state that decides any of this now lives in RTC memory, which
    survives a wake and is cleared by a power cut. Both of those are
    exactly the behaviour this wants.
    Rebuilt as three states and no others:
    power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
2026-11-14 7.15.0: a radio that is actually off
    The fault: smartNext and smartRetryAt were ordinary globals holding
    millis() readings. A deep sleep wake clears the first and restarts the
    second at nought, so every time the robot was picked up it came back
    believing the clock had never been fetched, brought Bluetooth up and sat
    there for forty five seconds. The radio was never off for longer than
    one wake. Both now live in RTC memory as moments on the wall clock.
    Second fault, and the one that was costing the battery: goDeep armed a
    three minute timer wake to look for the phone whenever anything had ever
    been bonded. It never asked whether Auto away was switched on, or
    whether the radio was meant to be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
